unal-edigital2-labs/2021-1-w07_entrega-_final-grupo14/Soc_project/Bluetooth/README.md

# Bluetooth :calling:
Se uso un dispositivo Bluetooth de referencia HC-05, este posee 4 pines, dos de alimentación y otros dos para ser conectados a una uart, las cuales estan comunicados con la FPGA siendo un pin RX para la lectura y otro TX para la escritura hacia el periférico, se realizo la creación de dos uarts (uart1 y uart3) dentro del archivo [buildSoCproject.py](/Soc_project/buildSoCproject.py) como copias de una Uart que ya venía con el proyecto. No se realizo un módulo en Verilog dado que manejamos el periferico con las Uart y el desarrollo de su funcionamiento se encuentra dentro del firmware como una función llamada **enviarM()** y **main()**. A su vez, cabe destacar que la comunicación es serial de tal forma que para enviar datos por el bluetooth se usaron funciones *for* con el fin de enviar dato a dato la matriz en donde se encuentra el robot y la información que ha sido detectada hacia un celular donde el usuario pueda observar esta información por medio de la aplicación Bluetooth terminal HC05.

<p align="center">
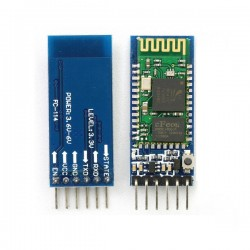
[picture p9: Imagenes/blue.jpg]
  
</p>

La conexión del bluetooth no se hizo directamente con la uart de la FPGA dado que hubo un problema de comunicación, de esta manera se conectaron la uart1 y uart3 a un Arduino MEGA 2560 y este solamente recibirá la información de las uart y transmitirá al periférico bluetooth para luego recibirla en el celular. La Uart1 se usó para transmitir la información de la matriz por donde el robot está pasando y lo que esta viendo, mientras que la Uart3 se uso para recibir los comandos dados por el usuario para activar ciertas funciones, se hicieron estas dos uarts para evitar problemas de sincronización a la hora de ejecutar las funciones.

Por ultimo, mostraremos el código de arduino que se usó para la comunicación con el bluetooth, por un lado se recibe lo que manda la FPGA y se transmite, y luego lo que llega por el bluetooth y se envía a la FPGA (para mas informacion remitase a [HC-05](/datasheets/Bluetooth.pdf)).

```C
     if(miBT.available()){
        dato1 = miBT.read();
        Serial3.write(dato1);

        }

      if(Serial3.available()){
        dato3 = Serial3.read();
        miBT.write(dato3);
        }
```
