unal-edigital2-labs/2021-1-w07_entrega-_final-grupo14/Soc_project/module/verilog/motor/README.md

# Motores ⚙️

Se utilizaron dos motores y un puente H (L298N) para el movimiento del robot cartógrafo, despues de varias pruebas se decidio alimentar a los motores con 12V para que tuvieran un desempeño óptimo (para mas informacion remitase a [L298N](/datasheets/l298.pdf)). 

<p align="center">
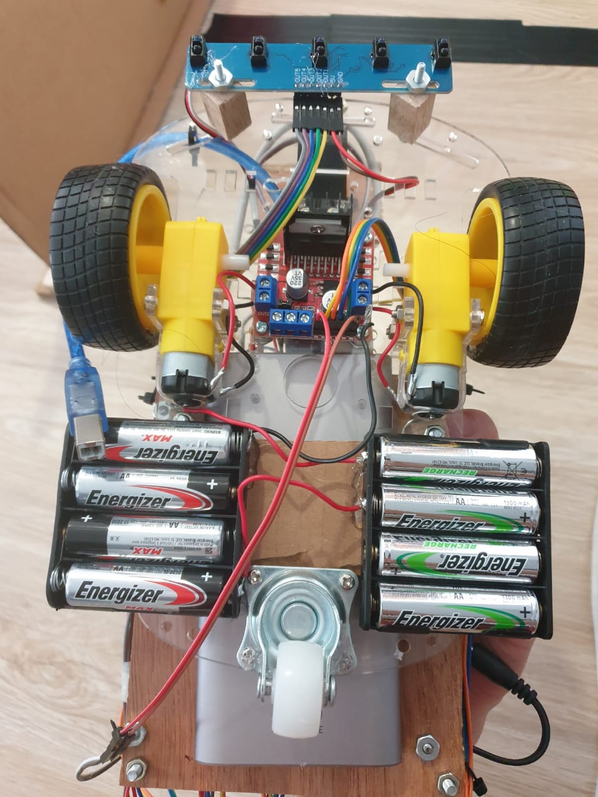
[picture p18: Imagenes/DC.jpeg]
  
</p>

El puente H, según los valores de sus entradas, permite que el robot avance, gire o se detenga, en la siguiente tabla se resumen las acciones que puede realizar dependiendo del valor de sus entradas.

 | Acción | S1 | S2 | S3 | S4 |
| ------------- | ------------- | ------------- |------------- |------------- |
| Avance | 0 | 1 | 1 | 0 |
| Retroceso | 1 | 0 | 0 | 1 |
| Giro Derecha | 1 | 0 | 1 | 0 |
| Giro Izquierda | 0 | 1 | 0 | 1 |
| Pausa | 0 | 0 | 0 | 0 | 

Teniendo en cuenta la anterior tabla se desarrollo el módulo [Motor.v](/Soc_project/module/verilog/Motor.v) que cumple la función de driver para los motores. El diagrama que describe las conexiones de este driver con el periférico es el siguiente:

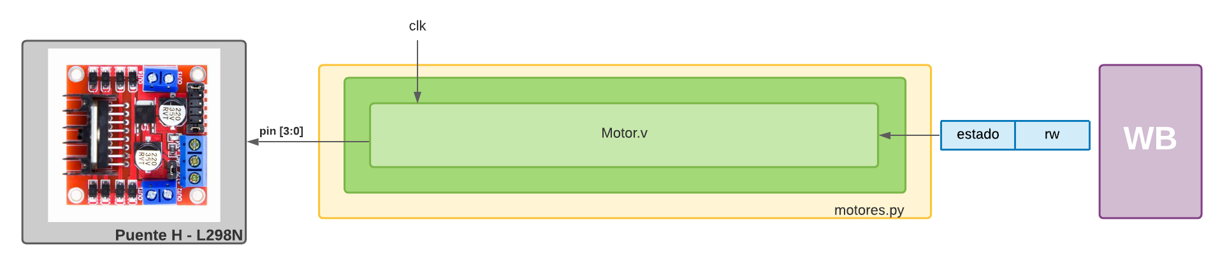
[picture p19: Imagenes/punteH.png]


Y la ubicación del registro en el mapa de memoria es:

<p align="center">
  
</p>

El código utilizado para la realización del módulo es el siguiente:

```verilog
    parameter AVANCE=2, RETROCESO=1, PAUSA=0, GIROD=3, GIROI=4;

    always @(posedge clk) 
    begin

          case(estado)
            AVANCE: pin = 4'b0110;
            RETROCESO: pin = 4'b1001;
            PAUSA: pin = 4'b0000;
            GIROD: pin = 4'b0101;
            GIROI: pin = 4'b1010;
          default:
            pin = 4'b0000;
          endcase
      end
  ```
      
El funcionamiento del módulo se basa en que según el valor de la señal de entrada **estado** se establecen los valores de los 4 pines de salida siguiendo la tabla descrita anteriormente para que los motores realicen la acción deseada.
