unal-edigital2-labs/2021-1-w07_entrega-_final-grupo14/Imagenes/DFP1.jpg

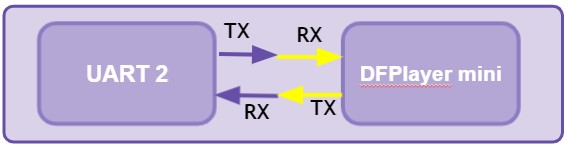
Imagenes/DFP1.jpg
