unal-edigital2-labs/2021-1-w07_entrega-_final-grupo14/Imagenes/mem_radar.PNG

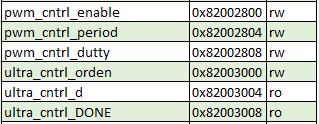
Imagenes/mem_radar.PNG
