unal-edigital2-labs/2021-1-w07_entrega-_final-grupo14/Soc_project/firmware/uart1.c

#include "uart1.h"
#include <irq.h>
#include <generated/csr.h>

void uart1_init(void)
{
	uart1_ev_pending_write(uart1_ev_pending_read());
	uart1_ev_enable_write(UART1_EV_TX | UART1_EV_RX);
//	irq_setmask(irq_getmask() | (1 << UART1_INTERRUPT));
}



void uart1_isr(void)
{

}

char uart1_read(void)
{
/*se bloquea si no hay lectura debe esperar dato de lo contrario el procesador se bloquea*/
	char c;
	while (uart1_rxempty_read());
	c = uart1_rxtx_read();
	uart1_ev_pending_write(UART1_EV_RX);
	return c;
}

int uart1_read_nonblock(void)
{
	return (uart1_rxempty_read() == 0);
}

void uart1_write(char c)
{
	while (uart1_txfull_read());
	uart1_rxtx_write(c);
	uart1_ev_pending_write(UART1_EV_TX);
}


void uart1_sync(void)
{
	while (uart1_txfull_read());
}
